vasilijebatas/Remote-controle-vehicle-using-RF-module/(list of files, drawings)

Other design files:
prijemnik/components.SchLib
prijemnik/footprints.PcbLib
prijemnik/Other_devices.SchLib
prijemnik/PCB.PcbDoc
prijemnik/prijemnik.PrjPcb
prijemnik/prijemnik_sematik.SchDoc
